LamKamhang/TracingCar/doc/工程训练/软件流程图.pdf

# 工程训练竞赛软件设计流程图 刹车模块 巡线模块 抓取模块 识别模块 抓取模块 识别模块 巡线模块

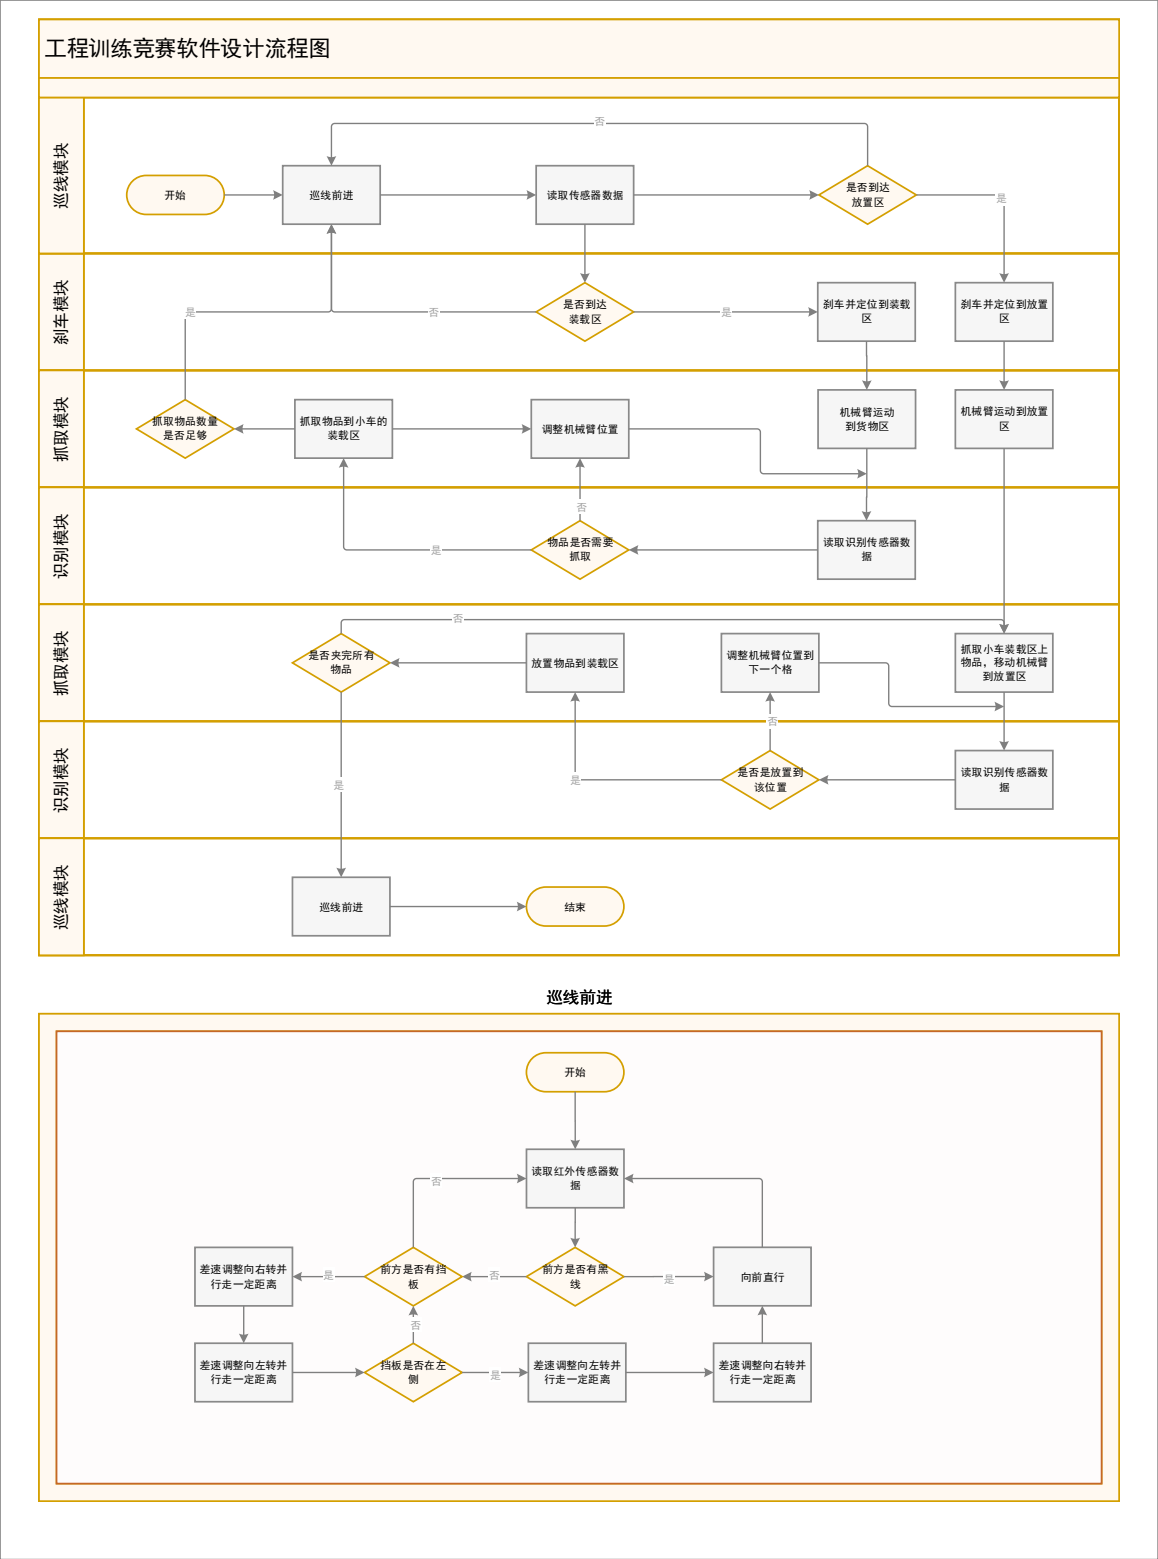
[picture p53: page 1]
巡线前进; 是否到达 装载区; 读取传感器数据; 刹车并定位到装载 区; 读取识别传感器数 据; 机械臂运动 到货物区; 物品是否需要 抓取; 抓取物品到小车的 装载区; 调整机械臂位置; 抓取物品数量 是否足够; 是否到达 放置区; 刹车并定位到放置 区; 机械臂运动到放置 区; 抓取小车装载区上 物品，移动机械臂 到放置区; 是否是放置到 该位置; 调整机械臂位置到 下一个格; 放置物品到装载区; 是否夹完所有 物品; 读取红外传感器数 据; 前方是否有黑; 向前直行 差速调整向右转并; 行走一定距离; 前方是否有挡 板; 差速调整向左转并 行走一定距离; 挡板是否在左 侧; 差速调整向左转并; 差速调整向右转并 行走一定距离
