LamKamhang/TracingCar/src/integrate/util.hpp

#pragma once

#define	G0000000	0
#define	G0000001	1
#define	G0000010	2
#define	G0000011	3
#define	G0000100	4
#define	G0000101	5
#define	G0000110	6
#define	G0000111	7
#define	G0001000	8
#define	G0001001	9
#define	G0001010	10
#define	G0001011	11
#define	G0001100	12
#define	G0001101	13
#define	G0001110	14
#define	G0001111	15
#define	G0010000	16
#define	G0010001	17
#define	G0010010	18
#define	G0010011	19
#define	G0010100	20
#define	G0010101	21
#define	G0010110	22
#define	G0010111	23
#define	G0011000	24
#define	G0011001	25
#define	G0011010	26
#define	G0011011	27
#define	G0011100	28
#define	G0011101	29
#define	G0011110	30
#define	G0011111	31
#define	G0100000	32
#define	G0100001	33
#define	G0100010	34
#define	G0100011	35
#define	G0100100	36
#define	G0100101	37
#define	G0100110	38
#define	G0100111	39
#define	G0101000	40
#define	G0101001	41
#define	G0101010	42
#define	G0101011	43
#define	G0101100	44
#define	G0101101	45
#define	G0101110	46
#define	G0101111	47
#define	G0110000	48
#define	G0110001	49
#define	G0110010	50
#define	G0110011	51
#define	G0110100	52
#define	G0110101	53
#define	G0110110	54
#define	G0110111	55
#define	G0111000	56
#define	G0111001	57
#define	G0111010	58
#define	G0111011	59
#define	G0111100	60
#define	G0111101	61
#define	G0111110	62
#define	G0111111	63
#define	G1000000	64
#define	G1000001	65
#define	G1000010	66
#define	G1000011	67
#define	G1000100	68
#define	G1000101	69
#define	G1000110	70
#define	G1000111	71
#define	G1001000	72
#define	G1001001	73
#define	G1001010	74
#define	G1001011	75
#define	G1001100	76
#define	G1001101	77
#define	G1001110	78
#define	G1001111	79
#define	G1010000	80
#define	G1010001	81
#define	G1010010	82
#define	G1010011	83
#define	G1010100	84
#define	G1010101	85
#define	G1010110	86
#define	G1010111	87
#define	G1011000	88
#define	G1011001	89
#define	G1011010	90
#define	G1011011	91
#define	G1011100	92
#define	G1011101	93
#define	G1011110	94
#define	G1011111	95
#define	G1100000	96
#define	G1100001	97
#define	G1100010	98
#define	G1100011	99
#define	G1100100	100
#define	G1100101	101
#define	G1100110	102
#define	G1100111	103
#define	G1101000	104
#define	G1101001	105
#define	G1101010	106
#define	G1101011	107
#define	G1101100	108
#define	G1101101	109
#define	G1101110	110
#define	G1101111	111
#define	G1110000	112
#define	G1110001	113
#define	G1110010	114
#define	G1110011	115
#define	G1110100	116
#define	G1110101	117
#define	G1110110	118
#define	G1110111	119
#define	G1111000	120
#define	G1111001	121
#define	G1111010	122
#define	G1111011	123
#define	G1111100	124
#define	G1111101	125
#define	G1111110	126
#define	G1111111	127
