LamKamhang/TracingCar/(commit log)

2018-07-25 stash current work
2018-07-26 remove gray and remove PID, using state machine to do tracing
2018-07-28 增加状态宏
2018-07-28 测试pid
2018-08-01 扫码模块
2018-10-02 fix some problem about the scan moduler, delay some time
    [scan.cpp, scan.h, scan.ino]
2018-10-03 fix motor to one driver
    [Motor.cpp, Motor.h, scan.h, scan.ino]
2018-10-03 add Servo
2018-10-03 fix PID parameter
2018-10-03 fix PID parameter again.
    [integrate.ino, interface.h]
2018-10-03 add PID reset
2018-10-11 增加机械臂的舵机代码
2018-10-11 微调PID的状态
2018-10-11 增加扫码模块
2018-10-11 接口文件以及整体arduino代码
2018-10-11 fix scan buffer problem
    [integrate.ino, interface.h, scan.cpp, scan.h]
2018-10-12 scan modular has some bugs.
    [integrate.ino, interface.h, scan.cpp, scan.h]
